mateusz/tetrachromacy/(commit log)

2025-07-05 Update timers
2025-07-05 added software dither to pin 11
